Rennaafi/mpu6050-zybo-classifier/zybo_ps/scaler_params.h

#ifndef SCALER_PARAMS_H
#define SCALER_PARAMS_H

#include "uart_protocol.h"

// StandardScaler parameters from models/scaler.npz (fit by
// tools/train_classifier.py on the training set) — baked in here so the
// ESP32 can stay simple and just send raw feature values in natural units
// (g, deg/s, Hz); normalization happens on this side, right before
// fixed-point conversion, since that's already the last stop before the
// IP either way.
//
// *** Regenerate this if you ever retrain the model (Stage 4) — these
// *** must match the scaler that produced the currently-deployed weights.
// Order matches uart_protocol.h's feature layout: for each axis in
// [ax, ay, az, gx, gy, gz], [mean, std, min, max, fft_peak_hz].

static const float SCALER_MEAN[NUM_FEATURES] = {
    -0.1583779626691458f, 0.13433693578771327f, -0.4347725111287158f, 0.025507108799415812f, 3.47376214440965f,
    0.25228001685952106f, 0.24948974825018108f, -0.1487251193592572f, 0.7170616118193238f, 4.356295123484462f,
    0.9969095608563785f, 0.27289595869391875f, 0.5446161156392246f, 1.509445500317343f, 4.402317874804492f,
    -4.999990048482838f, 73.86016864163615f, -126.94117935630382f, 116.86971197169169f, 3.9972950525193416f,
    -4.71573936971902f, 56.0923379967563f, -102.28667762677816f, 91.68732728982141f, 4.164881496067861f,
    -3.4673214794635348f, 49.75708683265894f, -96.7093414646613f, 80.28792442714628f, 4.28537941374485f,
};

static const float SCALER_SCALE[NUM_FEATURES] = {
    0.2137843900629599f, 0.14914751961989975f, 0.5217352486987957f, 0.17519108991719118f, 2.58599188303117f,
    0.3214231802939047f, 0.28588789856611596f, 0.5209692060709403f, 0.7186315309573585f, 2.9310678334146303f,
    0.1927500953248998f, 0.3277319539138652f, 0.6232414878356138f, 0.6829958708340457f, 2.9514300981531596f,
    42.30017387323862f, 101.76280357733064f, 166.13233719735467f, 164.71995132312588f, 2.900991260413429f,
    23.829501084156718f, 64.75020070607805f, 123.86837912954218f, 111.90114323282828f, 2.5834251400058075f,
    16.593997062162227f, 59.639431152942564f, 121.23466977835398f, 102.53177680498133f, 2.7384182585570627f,
};

#endif
